Lokarin/equalizador_fft/etapa_3/software/stm32cube/Core/Inc/main.h

#define LED_DEBUG_Pin GPIO_PIN_13
#define LED_DEBUG_GPIO_Port GPIOC
#define LCD_DC_Pin GPIO_PIN_0
#define LCD_DC_GPIO_Port GPIOB
#define LCD_RESET_Pin GPIO_PIN_1
#define LCD_RESET_GPIO_Port GPIOB
#define LCD_CS_Pin GPIO_PIN_2
#define LCD_CS_GPIO_Port GPIOB
