Lokarin/equalizador_fft/(commit log)

2026-08-19 Mundança no templetes de entrada e da etapa1
2026-09-03 Expand README with hardware feasibility and requirements
    Added detailed feasibility study and hardware requirements for the audio equalizer project, including filter configurations, frequency bands, interface requirements, microcontroller selection, and power supply considerations.
2026-09-03 Update README with references and links
    Added references for audio equalizer and filtering concepts.
2026-09-03 Atualiza documentação inicial do projeto
    Ajusta a descrição da referência de tensão para refletir a necessidade de entrada positiva nos ADC do microcontrolador e menciona o uso de LTspice/Proteus como ferramentas de simulação. Também remove o espaço final da lista de referências do README da etapa 1.
2026-09-03 Revise README with circuit simulation insights
    Updated README.md with simulation results and design decisions for the audio equalizer circuit.
2026-09-10 ajuste diagrama de blocos do sistema gelra
2026-09-24 links para as referências da segunda etapa
2026-09-24 Atualiza README.md para Etapa 2 do projeto
    A Etapa 2 detalha a consolidação do projeto do equalizador, incluindo a arquitetura do circuito, firmware e esquemático elétrico. Foram completadas as subentregas, como o diagrama de blocos e a definição da interface com equipamentos externos.
2026-09-24 Update README with additional references
    Re-Added references for LMC660 and STM32F411.
2026-09-24 Revise project stages and requirements in README
    Updated project timeline and requirements sections.
2026-09-24 Documentar firmware e diagramas do sistema
    Atualiza o README da etapa 2 com a descrição do firmware STM32, incluindo o fluxo de aquisição, FFT e exibição em display, além dos diagramas de blocos e estados do sistema. Também inclui os arquivos de imagem usados para ilustrar a organização do firmware e reforçar a documentação do projeto.
2026-11-05 Adiciona imagens de validação do equalizador
    Inclui imagens de validação para as faixas alta, média e baixa.
2026-11-05 README etapa 3 e mudança de diretórios das imagens de fft
2026-11-05 Gif reduzido e correção no consumo de corrente
2026-11-05 Referenciamento de imagems
